Mayur62987/Lowcost-Lidar-scanner/README.md

The Aim of this project was to build a cost effective localization system for an AGV (Automated Guided Vehicle)
The system was proposed as a viable alternative to fixed track navigation by the utilization of trilateration with a lidar sensor
