Mayur62987/Lowcost-Lidar-scanner/Project Part B final.pdf

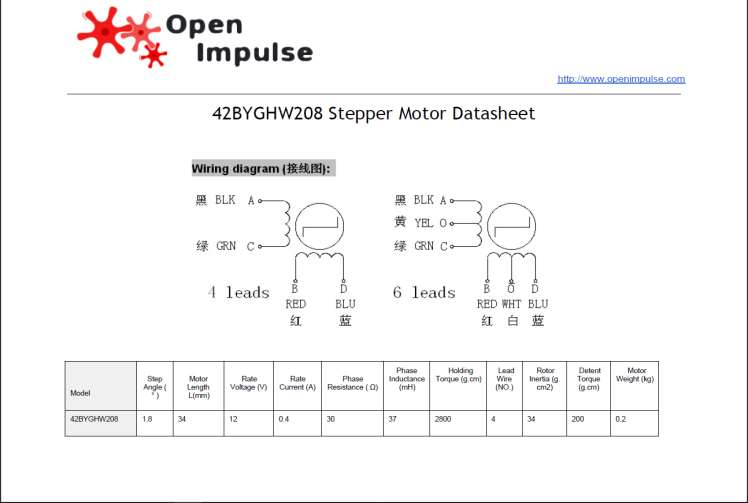
[picture p81: figure]
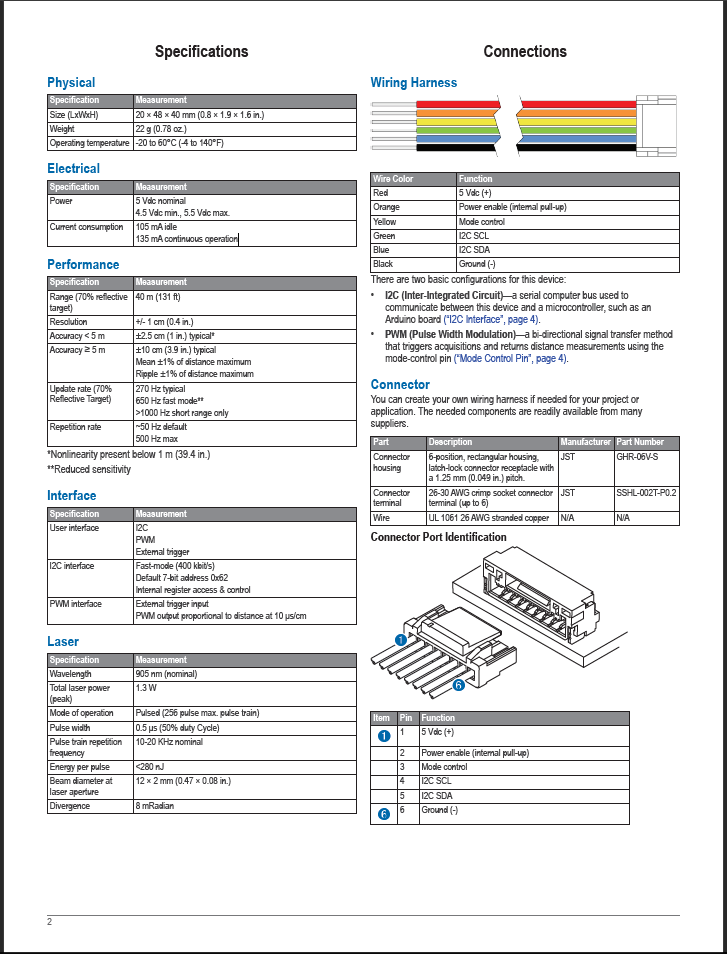
[picture p82: figure]
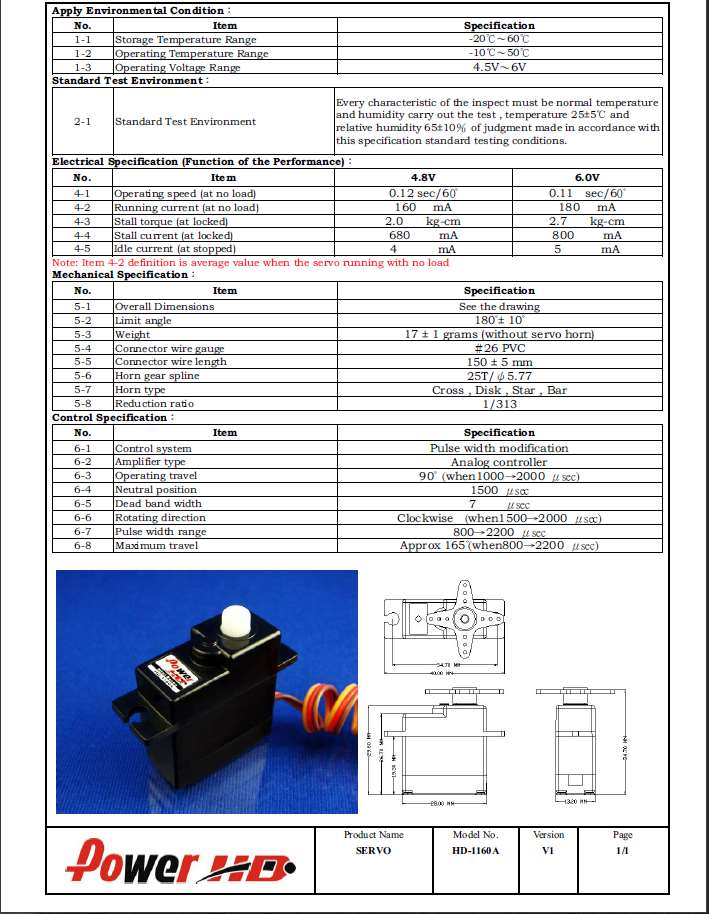
[picture p83: page 125]
